DonaldNgai/Quaduino/Eagle Sketches/First.brd

## EAGLE design Eagle Sketches/First.brd (2016-04-30)

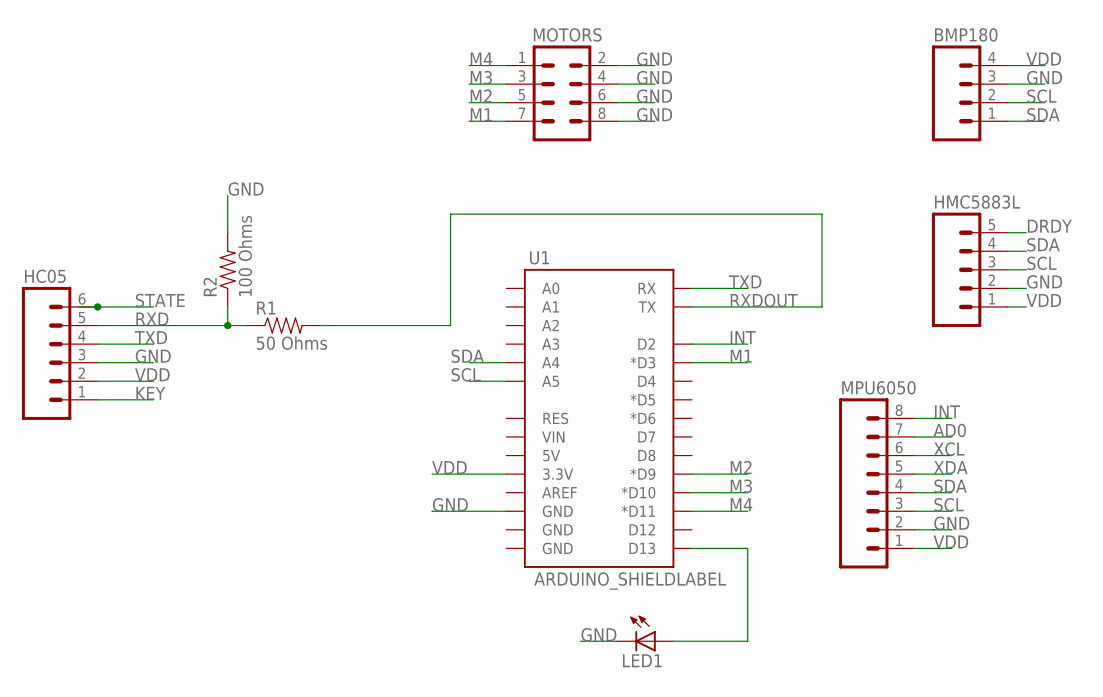
[picture p1: schematic First.sch]

Parts:
BMP180: M04PTH; 1X04
HC05: M06NO_SILK_FEMALE_PTH; 1X06_NO_SILK
HMC5883L: M05_ROUNDONLY_NOSILK; 1X05_ROUNDONLY_NOSILK
LED1: LED5MM
MOTORS: M04X2; 2X4
MPU6050: M08NO_SILK; 1X08_PIN1_NO_SILK
R1: 50 Ohms; SPARKFUN_AXIAL-0.3
R2: 100 Ohms; SPARKFUN_AXIAL-0.3
U1: ARDUINO_SHIELDLABEL; DUEMILANOVE_SHIELD

Connections:
AD0: MPU6050.7
DRDY: HMC5883L.5
GND: BMP180.3, HC05.3, HMC5883L.2, LED1.K (C), MOTORS.2, MOTORS.4, MOTORS.6, MOTORS.8, MPU6050.2, R2.P$2 (2), U1.GND@2 (GND)
INT: MPU6050.8, U1.D2
KEY: HC05.1
M1: MOTORS.7, U1.D3 (*D3)
M2: MOTORS.5, U1.D9 (*D9)
M3: MOTORS.3, U1.D10 (*D10)
M4: MOTORS.1, U1.D11 (*D11)
unnamed: LED1.A, U1.D13
RXD: HC05.5, R1.P$1 (1), R2.P$1 (1)
RXDOUT: R1.P$2 (2), U1.TX
SCL: BMP180.2, HMC5883L.3, MPU6050.3, U1.A5
SDA: BMP180.1, HMC5883L.4, MPU6050.4, U1.A4
STATE: HC05.6
TXD: HC05.4, U1.RX
VDD: BMP180.4, HC05.2, HMC5883L.1, MPU6050.1, U1.3.3V
XCL: MPU6050.6
XDA: MPU6050.5

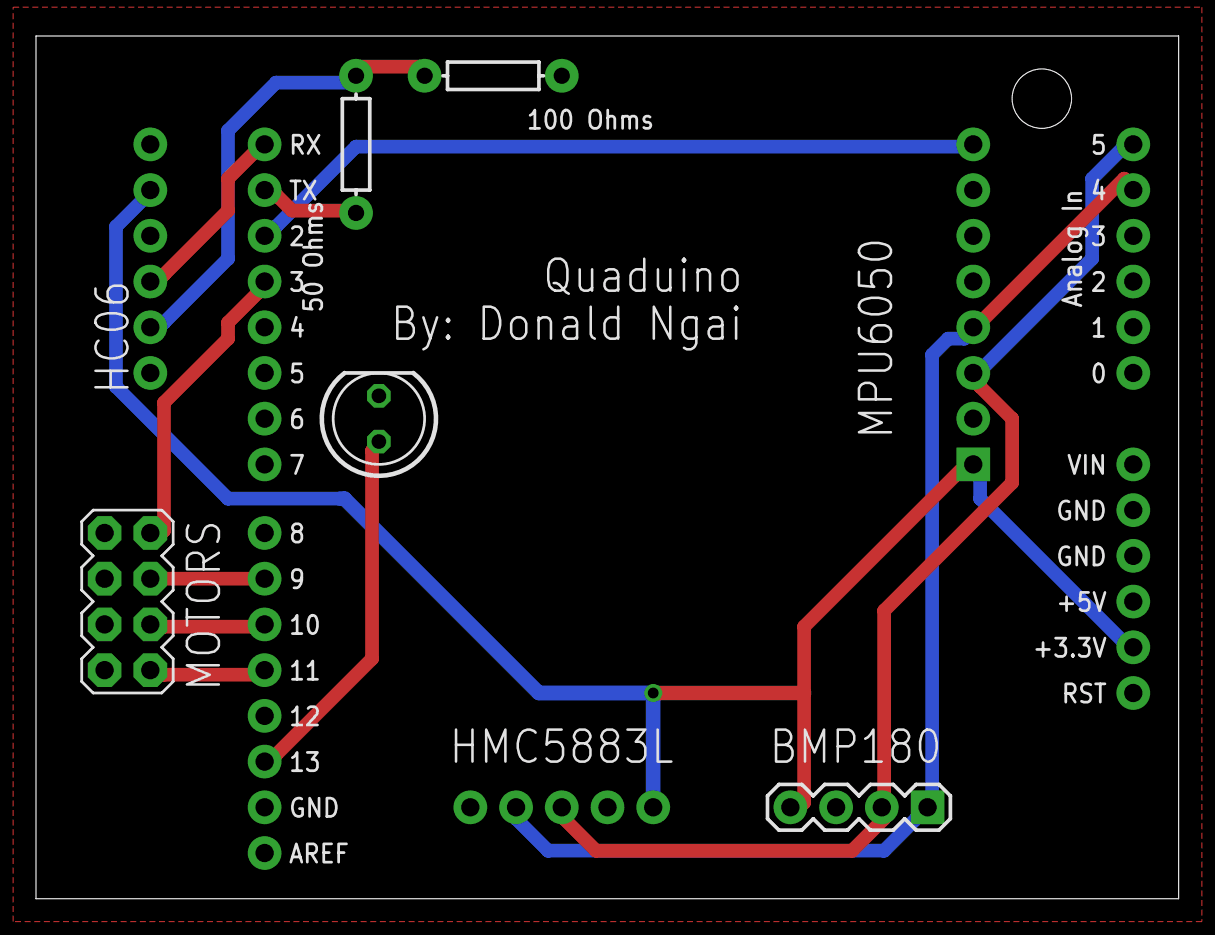
[picture p2: board First.brd from above]

Board: 2 copper layers, 63.5 x 47.9 mm, 9 parts (0 on the bottom side), 13 nets.
