DonaldNgai/Quaduino/PIDCont.cpp

/*
  Created by Basel Al-Rudainy, 6 april 2013.
  
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
  This library is distributed in the hope that it will be useful,
  but WITHOUT ANY WARRANTY; without even the implied warranty of
  MERCHANTABILITY or FITNESS FOR A PARTICULAR PURPOSE.  See the GNU
  Lesser General Public License for more details.
*/

#include "Arduino.h"
#include "PIDCont.h"

PIDCont::PIDCont()
{
pError = 0.0;
Ip = 0.000;
kp=0.000;
ki=0.000;
kd=0.000;
Hval=0;
Lval=0;
tp=millis();
}

void PIDCont::ChangeParameters(double mKp, double mKi, double mKd, double mLval, double mHval)
{
kp=mKp;
ki=mKi;
kd=mKd;
Lval = mLval;
Hval = mHval;
}

double PIDCont::Compute(double mError)
{
unsigned long tn = millis();
double dt=(double)(tn-tp);
  double P = (double) kp * mError;
  double D = (double) (kd * (mError-pError) * 1000.0/dt);
  pError = mError;
  double I = (double) (Ip + ki * mError * dt /1000.0);
  double U = (double) (P + I + D);
  Ip = I;
  tp=tn;
//  Serial.print("E:" + String(mError) + "P:" + String(P) + "kp:" + String(kp) + "U:" + String(U) + "I:" + String(I) + "D:" + String(D));
  if(U>Hval){
    U = Hval;
  }
  else if (U<Lval){
    U = Lval; 
  }
//  Serial.println("Uf:" + String(U));
return U;

}

double PIDCont::Compute(double mError,double dError,double setP)
{
unsigned long tn = millis();
double dt=(double)(tn-tp);
  double P = (double) kp * mError;
  double D = (double) (kd *((setP*1000/dt)-dError));
  pError = mError;
  double I = (double) (Ip + ki * mError * dt /1000.0);
  double U = (double) (P + I + D);
  Ip = I;
  tp=tn;
  if(U>Hval){
    U = Hval;
  }
  else if (U<Lval){
    U = Lval; 
  }
return U;

}

void PIDCont::resetI()
{
Ip=0.0;
tp=millis();
}
