DonaldNgai/Quaduino/(commit log)

2015-10-07 Fixed setting PID values from bluetooth to receive data correctly. Added in the ability to receive max and min of PID values. Need to add in receiving Yaw sensor data and add in HMC5883L
    [Init.h, Quaduino.ino]
2016-01-01 Removed BMP, changed PID values, and fixed compensating not getting to all motors
2016-03-15 Added button compatibility and debug screen and sensor acquisition
2016-03-15 Having trouble calibrating yaw
2016-03-16 Done except changing hard coded values, refactoring and making sure phone calibration is working
2016-03-16 added in throttle to data string
2016-03-16 Made throttle only work if arm and begin are checked
2016-03-19 Changed up to allow for arduino to notify that it is stable
2016-03-21 Added in change pid flag, fixed changing PID code, removed a lot of debugging print statements works really well!
    [Quaduino.ino]
2016-03-21 Changed order or bluetooth data, i think i changed it to 50Hz, added ChangePID flag
2016-03-22 fixed up calibrating drone button
    [Quaduino.ino]
2016-03-22 fixed calibrating and now just need to make android application remove old text to not slow it down
    [Quaduino.ino]
2016-04-02 Need to recalibrate the offsets for MPU, changed starting PID values, removed some commented out code, added code to set YPR after waiting for MPU to stabilize
    [Global.h, Init.h, Quaduino.ino]
2016-04-23 Got a bit more working
    Still not sure why adding in serial print lines make the controller work
    but it does. Also, I have a suspicion that the smoothed values are
    causing problems so i am outputting what the smoothed value is. Lastly,
    i want to try again at calibrating the ESC's in hope that it will fix
    the one motor being stronger problem.
    [Global.h, Quaduino.ino]
2016-04-23 Change PID start values. These values were pretty good
2016-04-24 Need to fix sensor jumps, need to make sure android YPR is accurate
    Made debug screen smaller on android, calibrated esc so that fixed
    problem of one motor being stronger than others. I also changed from
    analog write to using the servo library .write function.
    [Global.h, Init.h, Quaduino.ino]
2016-04-24 Fixed phone yaw,pitch,roll
2016-04-25 Fixed sensor jumps, and removed flagged for mpu interrupt which increased data speed(good)
    There was a static int inside the smoothing function so all the yaw
    pitch and roll smoothing calls were all referring to the same int so as
    a result, only 3/9 of the places in the array was ever used. I changed
    that and now that should also smooth out any spikes
    [Global.h, Quaduino.ino, Smooth.h]
2016-04-30 Added in failsafe, changed PID value a bit, added getActivityForResult in android, added eagle sketches
    [First.brd, First.sch]
2016-05-01 Added in checksum, changed PID value a bit, changed layout of android app so that it shows what it is sending currently
2016-05-17 Made seekbar draggable but need to account for edge case where i click with 10 of original but boxes aren't checked
2016-05-17 Included the folder of libraries needed to be installed with arduino for compilation
2016-05-18 Refactored some code to make it local variables to free up some SRAM, also, added in functionality to limit frequency of PID caluclations
2016-06-01 Changed yaw error so it doesn't jump when it goes from -180 to 180
    [Quaduino.ino]
2016-06-14 Changed offsets and changed PID value
2016-07-17 Changed max pid values
2016-08-14 Changes after Asking for Help
    Changed Main Loop flow
    Changed Millis to Micros
    Changed smoothing library to only calculate ints
    Added Scaling for DMP values
2016-08-16 Got 600 Hz Fast Loop!!!
    Changed main loop to contain fast and slow loop
    Updated retrieving DMP logic as well as placed smoothing in that
    function
    Made Bluetooth more consistent by implementing if statement
    Removed Print statements
    Added in ability to read gyro data
2016-08-19 Got rid of crashing
    Removed usage of DMP
    Instead, uses complimentary filter now using raw accel and gyro values
    to determine orientation
    need a filter for accel data
    PID results are acting weird, gotta check it out
    [Global.h, Init.h, Quaduino.ino, Sensor.ino]
2016-09-26 Changed smoothing and also fixed it so taht it actually uses the right buffer size
    [Global.h, Quaduino.ino, Sensor.ino, Smooth.h]
2016-09-27 Made graphic changes to android app, divided raw gyro by sensitivity, changed pid
2016-09-30 Motor jitter was caused by bad packets, added return statement to not proecess bad packets. PIDroll_val was also flipped
    [Global.h, Quaduino.ino]
2016-09-30 Added crazy angle failsafe, changed angle pid, still need to add in yaw lock using another angle pid loop
    [Global.h, Sensor.ino]
2016-10-12 Orientation calculation was flipped for roll and pitch, changed control pid to use simpled pid function, made sure correct motors were compensating
    [Quaduino.ino, Sensor.ino]
2016-10-12 changed crazy angle threshold, and switch phone roll and pitch
2016-11-05 Added in filter for accelerometer data but not working
    [Global.h, Sensor.ino]
2017-05-30 Adding LSB sensitivity for accelerometer
2017-06-02 Cleaned up gyro code, and added in high pass filter for gyroscope data
2017-06-02 Corrected trig functions to get pitch and roll using accel data
    [Global.h, Sensor.ino]
